oboucher/PestAlert/Website/SDP Website/Files/Images/Madelyn.jpg

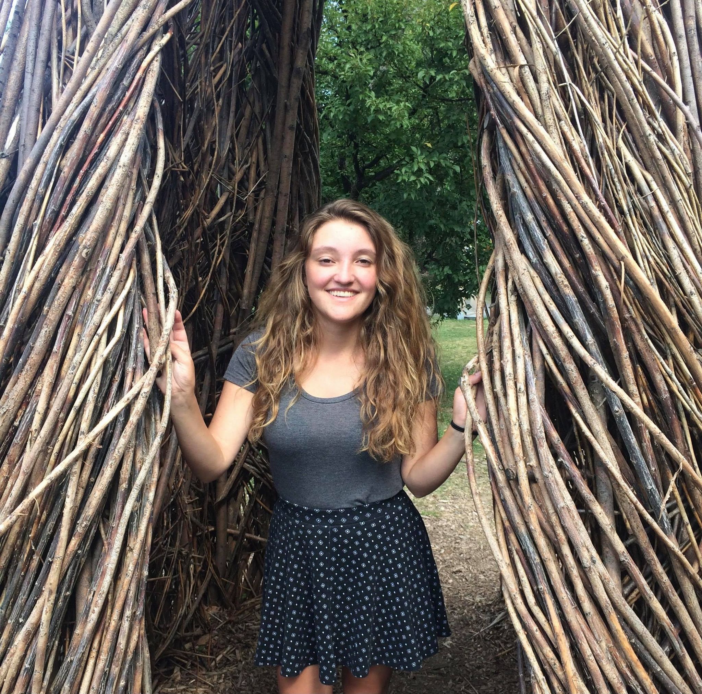
Website/SDP Website/Files/Images/Madelyn.jpg
