oboucher/PestAlert/Website/SDP Website/Files/Images/Owen.jpg

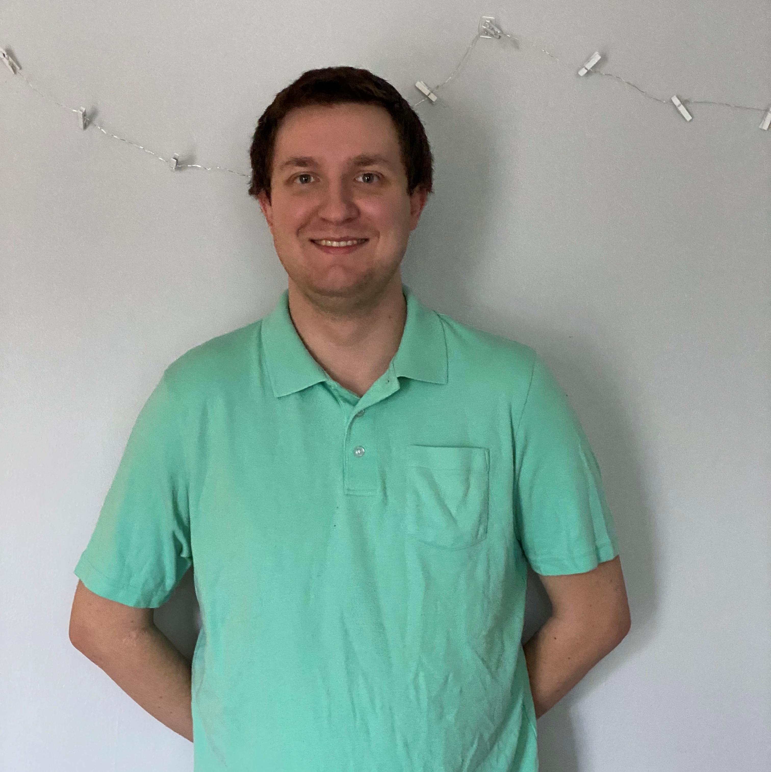
Website/SDP Website/Files/Images/Owen.jpg
