oboucher/PestAlert/Website/SDP Website/Files/Slides/PDR_Slides.pdf

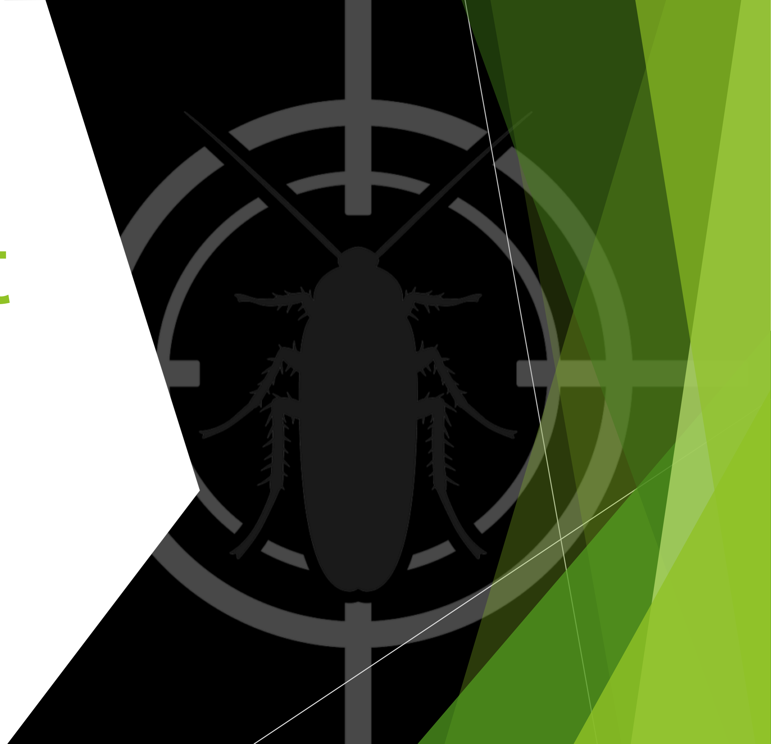
[picture p3: figure]

# Pest Alert

## Group 22 Aisha Ben-Neticha (EE) Owen Boucher (EE) Angela Wong (CompE) Madelyn Wright (EE)

# Problem Statement

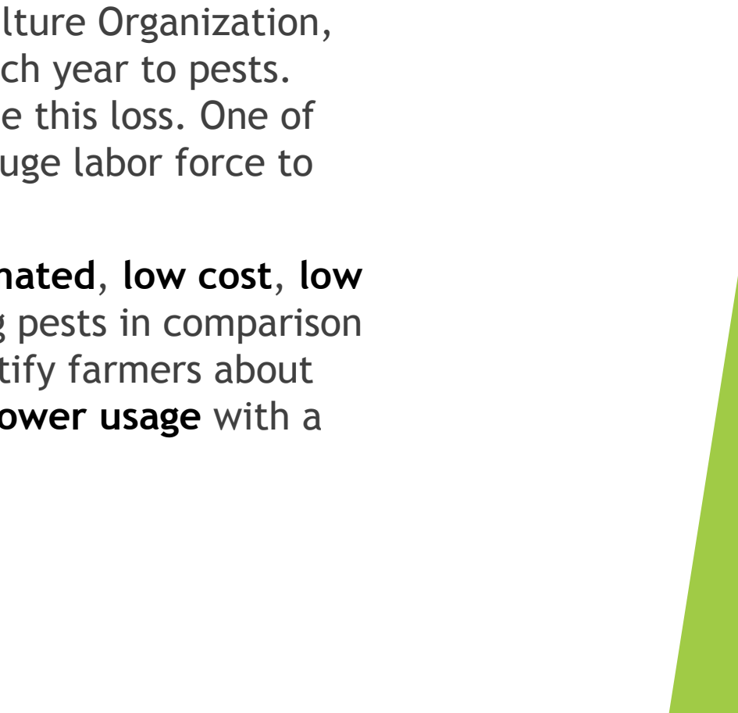
[picture p4: figure]

According to the United Nations Food and Agriculture Organization, between 20 and 40 percent of food crops are lost each year to pests.

### Integrated Pest Management, or IPM, can help reduce this loss. One of the major problems facing IPM is that it requires a huge labor force to

monitor pests.

### Our system, Pest Alert, seeks to create an automated, low cost, low power, and low maintenance system for monitoring pests in comparison to its competitors. Our system will automatically notify farmers about possible infestations, as well as managing its own power usage with a

solar panel and battery.

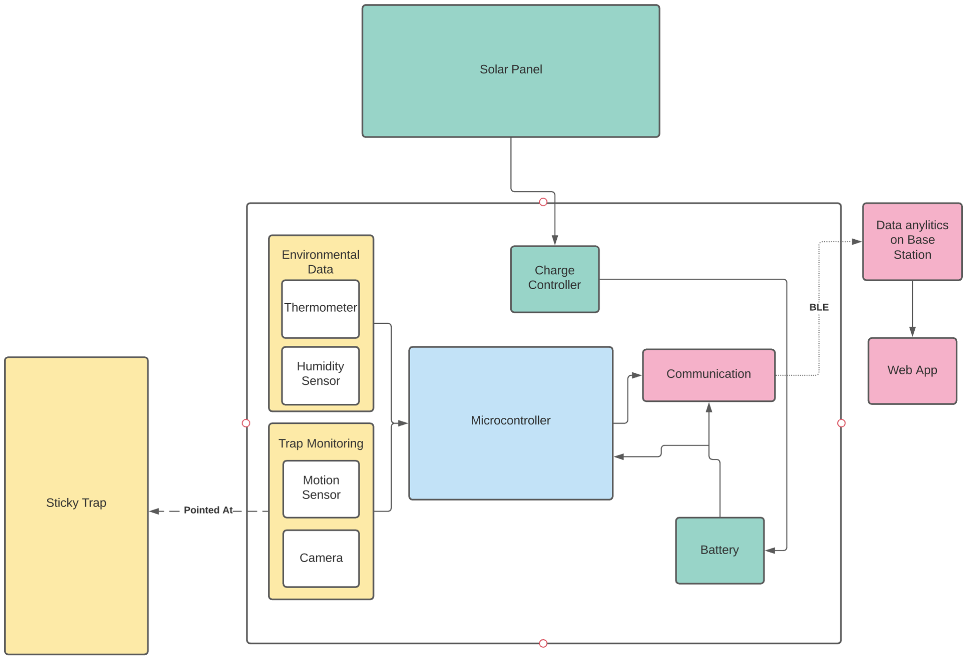
[picture p5: page 3]

# Competing Solutions -Microsoft/Azure Farm Beats

u Service that uses ML and
AI to help farmers
u Uses data-driven techniques to increase agricultural productivity by
enabling data collection from sensors, cameras, and drones.
u Weakness: Relies on a big battery or resort to minimal operation during night or extreme weather conditions such as snow and clouds. Farmbeats is also significantly more complex and requires users to have knowledge of Azure web services.

# Competing Solutions

# Rentokil Digital Pest Control

u Provide customers unrivaled pest data, insights and reporting to help proactively prevent, monitor and manage pests with efficiency
and control.
u Uses infrared beams and
sensor technology
u Insect light traps that use LED lighting rather than traditional fluorescent tubes, reducing energy uses by up to 70%
u This company focuses more on non
toxic solutions to pests rather than monitoring, whereas our solution is doing more by identifying pests and counting the total

# Competing Solutions

# Trap View

u This is an energy independent and weather resistant system with pheromone traps that send pictures of lured pests.
u All pictures from pest traps are gathered, processed and securely archived. The pests that are recognized are automatically marked.
u An application with powerful analytical tools allows you to efficiently monitor and successfully respond to the situation in the field.
u This product focuses on simplicity, while ours will also address cost and in turn power efficiency. It also uses pheromone traps which limits the pests.

# System Specifications

u System must be operable in the range of 0ºC to 50ºC
u Sensors
u Low powered camera to capture images of and identify number of pests on sticky trap (<5mW) u Motion detection determines beginning of system functionality in order to reduce power consumption
u Temperature/Humidity sensors to collect surrounding environmental data and observe correlation between environment and pest accumulation
u Power
u Battery life of 24 hours on full charge: Used to power sensors and should last at least 3 months (with charging) without any interference
u Solar Panel: Recharge half of the battery with one day of sunlight
u Reduce monitoring at night and operate in very low power mode by reducing overall operation because energy cannot be harvested in the dark
u Traps should be replaced every two months, when they are full, or when they lose their stickiness. u Low power communication between sensors and server using Bluetooth Low Energy (<100mW)

# Software Design

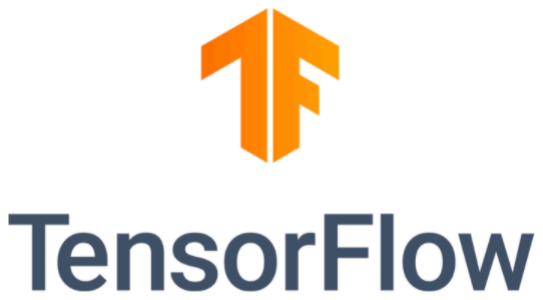
[picture p6: figure]

u Web Application Running on Base station u TensorFlow Lite using IP102 dataset
u MYSQL Database
u Possible User Interface -->
u Sending sensor data to Base station over BLE u Click on desired sensor name
u Real time sensor data shown
u Click and data will be sent to server
u Notifying user when pest count goes over threshold
u Showcasing images taken from camera

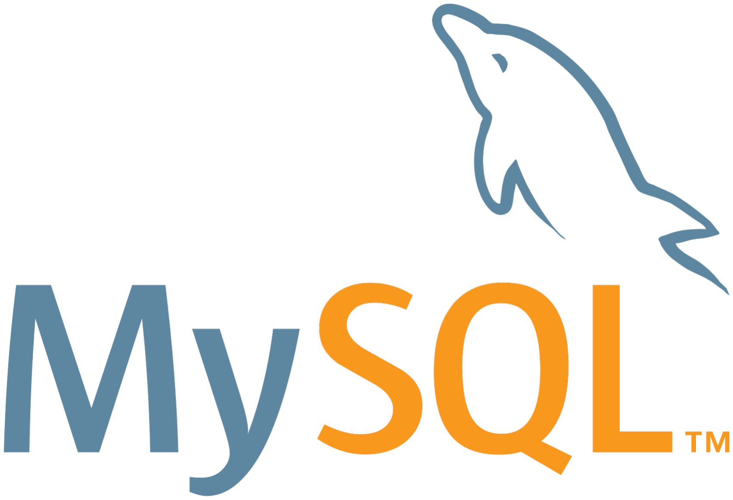
[picture p7: figure]

# Data Requirements

u Collecting/Storing/Testing Data u Temperature
u Humidity
u Number of pests
u Type of pests

u TensorFlow Lite
u IP102 dataset for training

u https://github.com/xpwu95/IP102

# Significant Custom Hardware Design

u Low power microcontroller
u Microchip SAM L10: ATSAML10D16A-YF u BLE
u SPBTLE-RF
u Sensors
u Temperature: TMP36
u Humidity: SHTC3
u Motion Detector: IRA-S210ST01
u Camera: Arducam 2MP Plus OV2640
u Solar Panel: Seeed 313070004, 1W Solar Panel u Rechargeable Battery: 18650 cell @ 2500mAh u Charge IC: TI BQ2057CSNTR

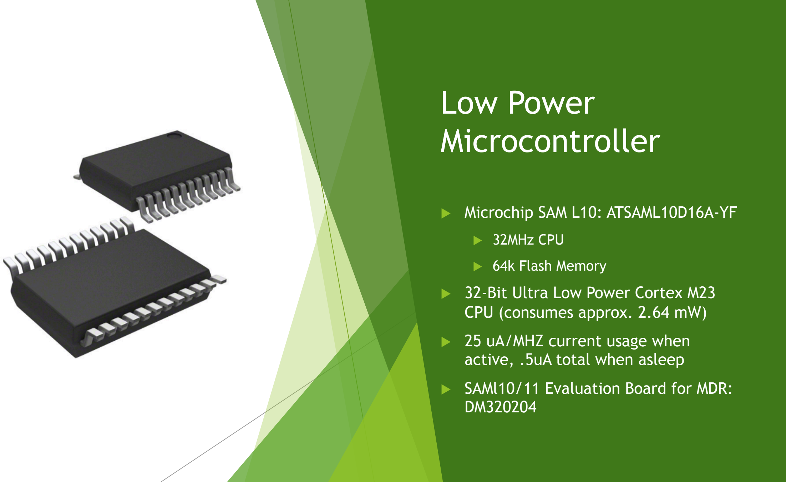
[picture p8: figure]
Low Power Microcontroller; u Microchip SAM L10: ATSAML10D16A-YF; u 32MHz CPU; u 64k Flash Memory u 32-Bit Ultra Low Power Cortex M23 CPU (consumes approx. 2.64 mW); u 25 uA/MHZ current usage when active, .5uA total when asleep; u SAMl10/11 Evaluation Board for MDR: DM320204

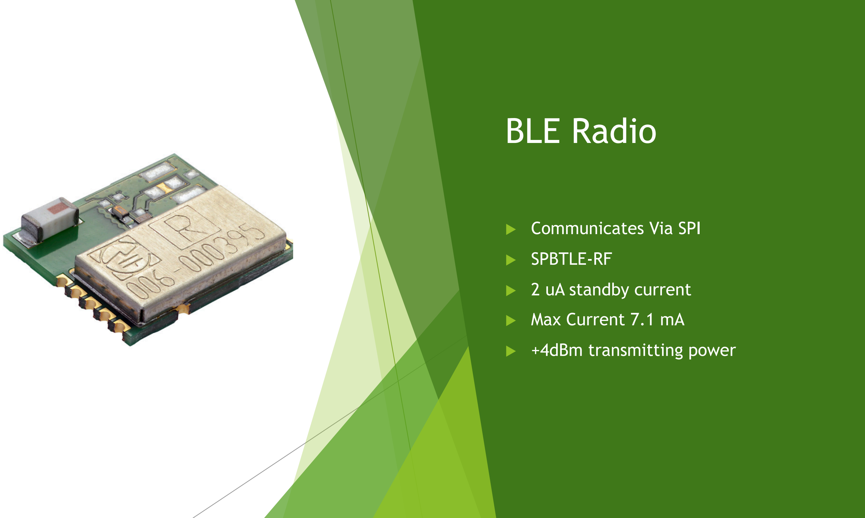
[picture p9: figure]
BLE Radio; u Communicates Via SPI; u SPBTLE-RF; u 2 uA standby current u Max Current 7.1 mA; u +4dBm transmitting power

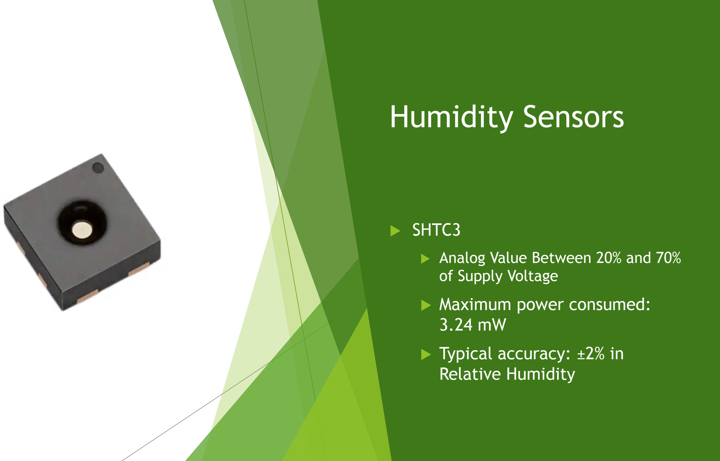
[picture p10: figure]
Humidity Sensors; u SHTC3; u Analog Value Between 20% and 70% of Supply Voltage u Maximum power consumed: 3.24 mW u Typical accuracy: ±2% in Relative Humidity

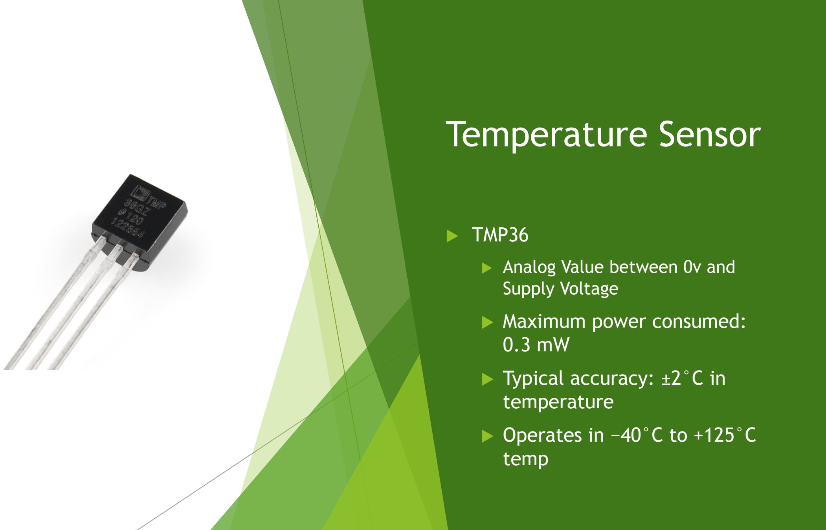
[picture p11: figure]
Temperature Sensor; u TMP36; u Analog Value between 0v and Supply Voltage u Maximum power consumed: 0.3 mW u Typical accuracy: ±2°C in temperature u Operates in −40°C to +125°C temp

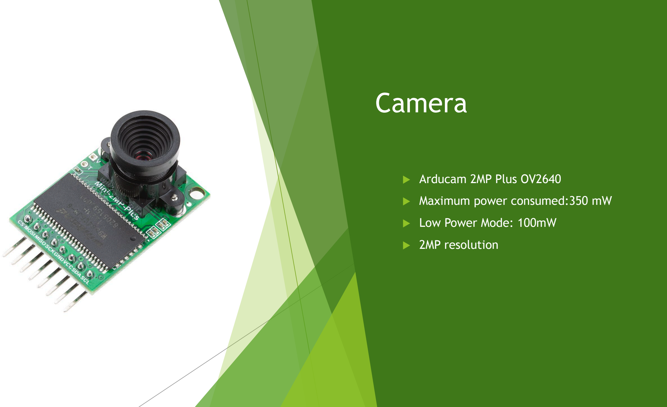
[picture p12: figure]
Camera; u Arducam 2MP Plus OV2640; u Maximum power consumed:350 mW; u Low Power Mode: 100mW; u 2MP resolution

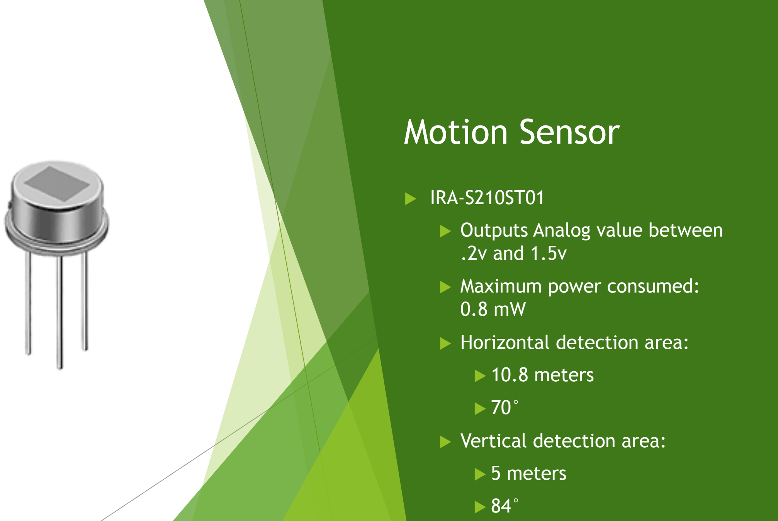
[picture p13: figure]
Motion Sensor; u IRA-S210ST01 u Outputs Analog value between .2v and 1.5v u Maximum power consumed: 0.8 mW u Horizontal detection area: u 10.8 meters u 70° u Vertical detection area: u 5 meters u 84°

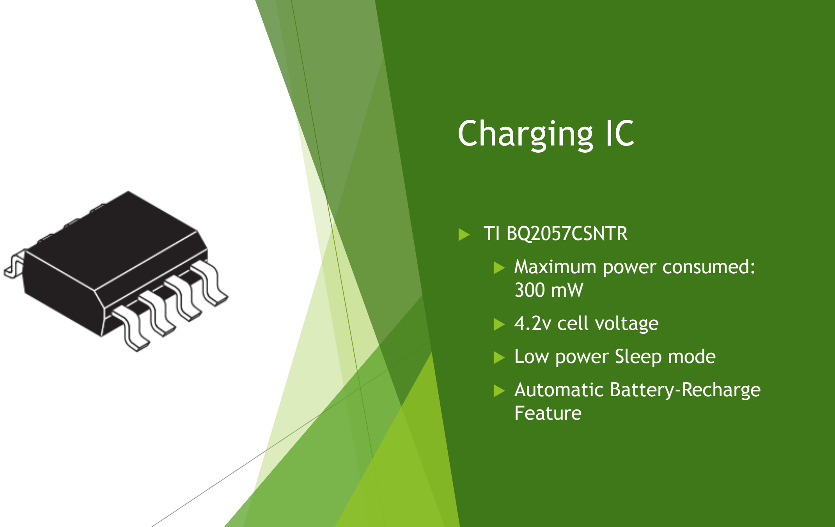
[picture p14: figure]
Charging IC; u TI BQ2057CSNTR u Maximum power consumed: 300 mW u 4.2v cell voltage u Low power Sleep mode u Automatic Battery-Recharge Feature

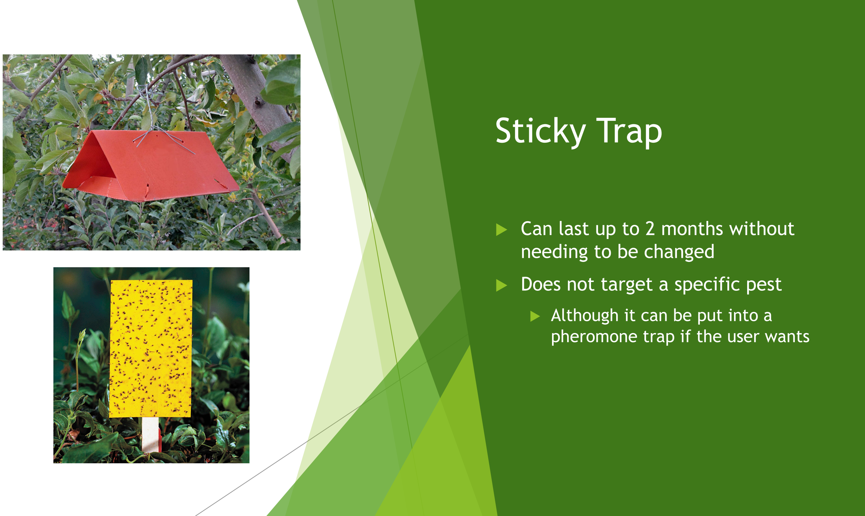
[picture p15: figure]
Sticky Trap; u Can last up to 2 months without needing to be changed u Does not target a specific pest; u Although it can be put into a pheromone trap if the user wants

# Solar Panel and Battery Sizing

Max Possible Power Use: approx. 400mW
Max Possible Energy Use Daily: 24hrs * 400mW = 9.6 Wh/day
The battery needs to be able to run without a solar power for one day, so we need a 9.6Wh battery.

This means for the battery we can use a single 18650 cell, rated at 3.7V and 2500mAh, because it can supply absolute maximum power for one day.

Assuming that the maximum power will not be reached due to the low power design of our system. We can use a 1W solar panel since it can supply enough power for the battery to almost fully recharge daily.

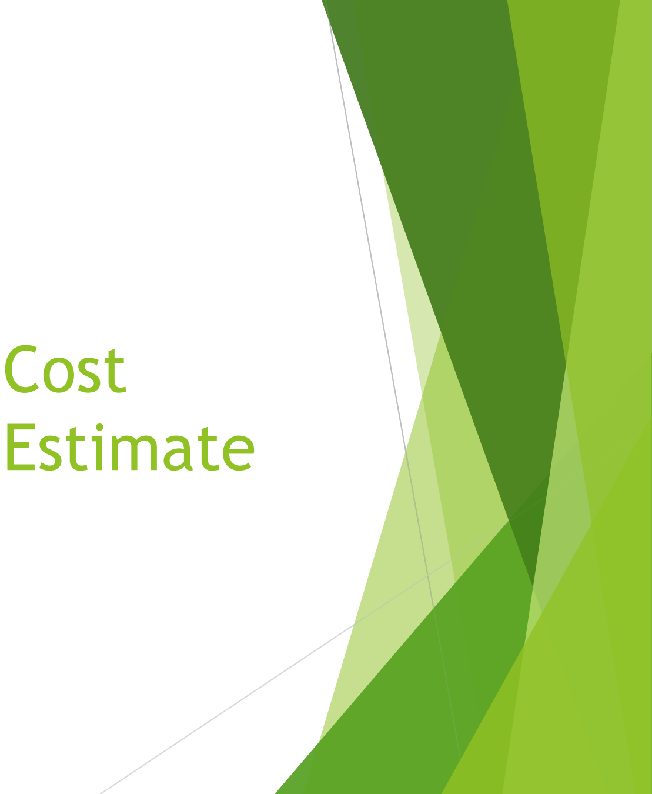
[picture p16: figure]
Cost Estimate

Component | Price($)
Microcontroller | 2.13
BLE Radio | 10.45
Humidity Sensor | 1.50
Temperature Sensor | 2.98
Camera | 9.95
Motion Sensor | 3.12
Charging IC | 2
Battery | 5
Solar Panel | 4
Sticky Traps | 9.99
Total Cost of Major Assembly Components | 51.12
SAM L10 Development Board | 60
Total Cost | 111.12

# Team Roles

u Communication, PCB, and Data Visualization: Owen Boucher u Pest Monitoring/Environmental Sensors : Aisha Ben-Neticha u Data Processing and Conditioning: Angela Wong
u Energy Management: Madelyn Wright

# Team Responsibilities

u Team Coordinator: Madelyn Wright
u Cost Lead: Angela Wong
u Altium Lead: Owen Boucher

# Proposed MDR Deliverables

Owen:
u BLE Communication established
u Framework of visual representation
Aisha:
u Temperature, humidity, and motion detecting sensors configured and functioning (w/ 70% accuracy) u Camera is configured; can capture images when motion sensor is triggered
Angela:
u Database configured, data conditioning is successful
u 70% accuracy in bug detection
Madelyn:
u Connection between solar panel and battery made u Code configured to operate in low power modes u Panel can successfully supply power to sensors

# Gantt Chart

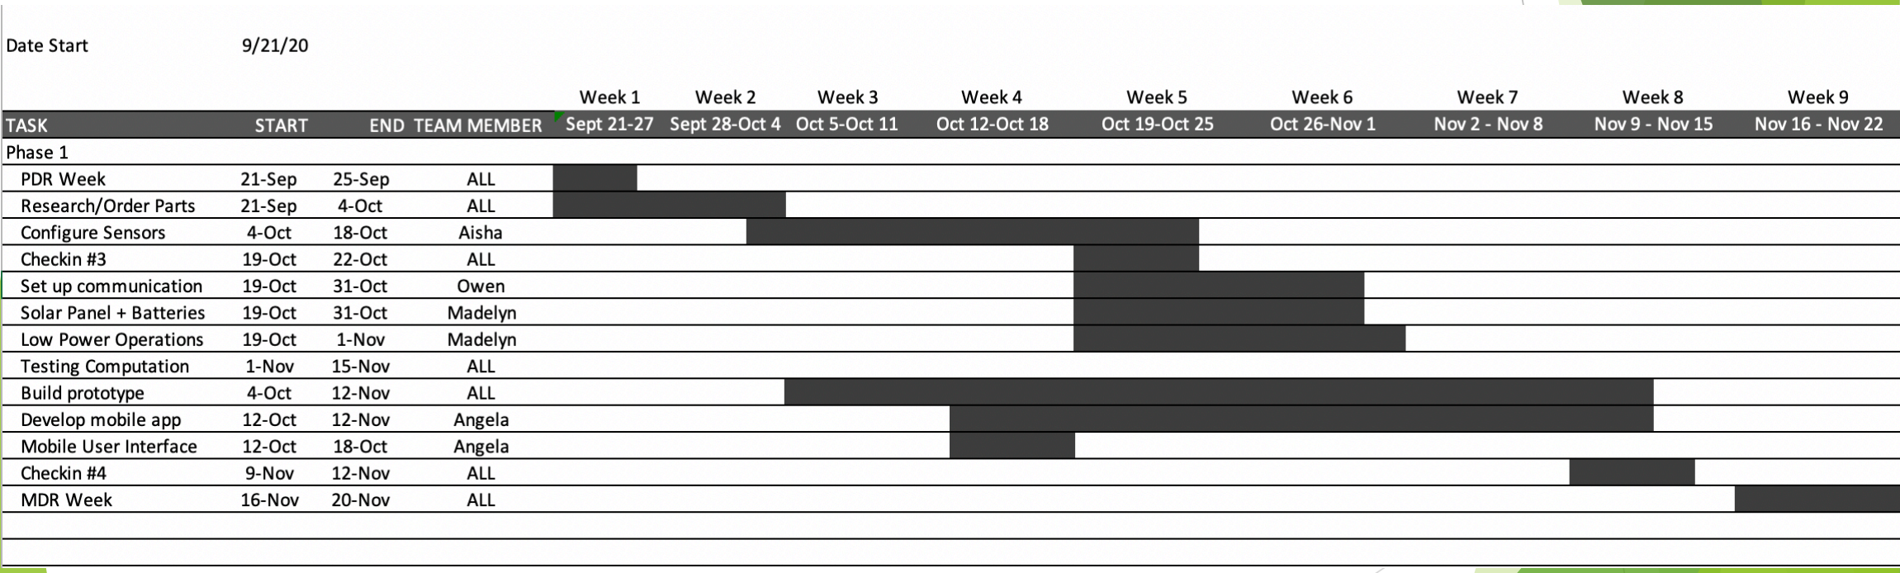
[picture p17: figure]

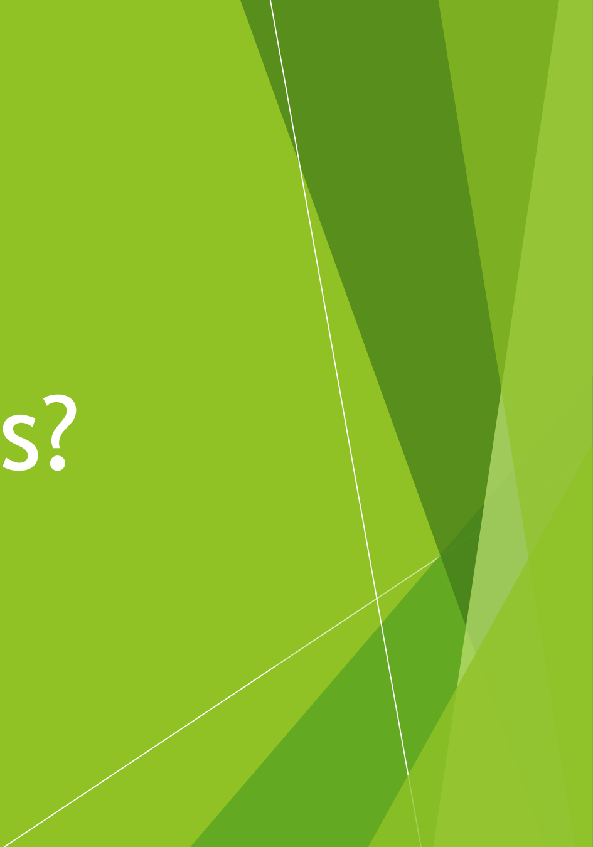
[picture p18: figure]

# Questions?
