oboucher/PestAlert/Website/SDP Website/Files/Images/Aisha.jpg

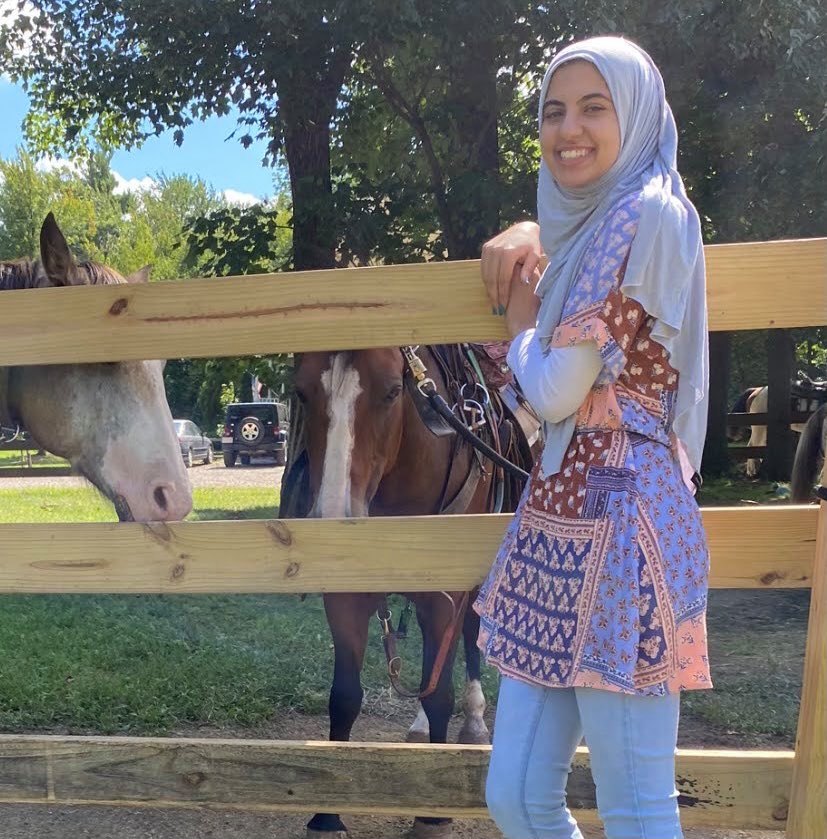
Website/SDP Website/Files/Images/Aisha.jpg
