oboucher/PestAlert/Website/SDP Website/Files/Images/Angela.jpg

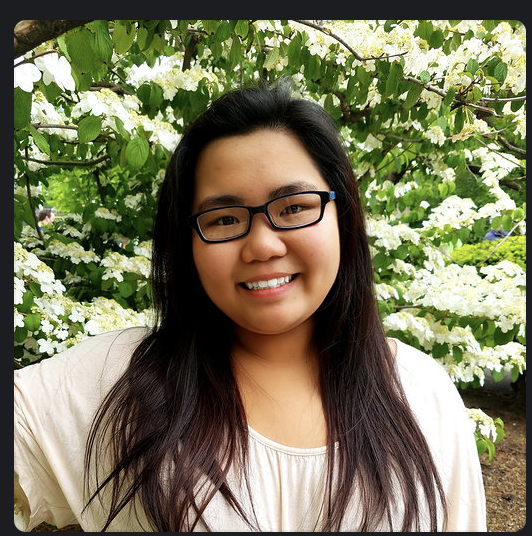
Website/SDP Website/Files/Images/Angela.jpg
