oboucher/PestAlert/Website/SDP Website/Files/Images/Hardware.jpg

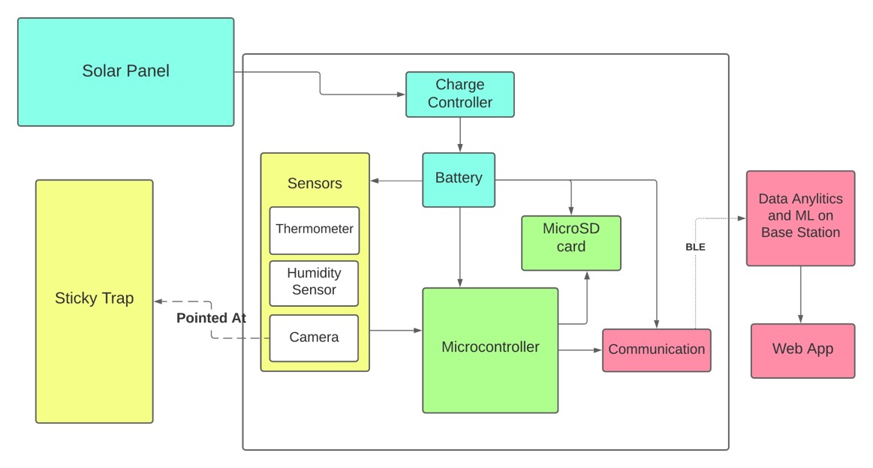
Website/SDP Website/Files/Images/Hardware.jpg
