oboucher/PestAlert/Website/SDP Website/Files/Images/Software.jpg

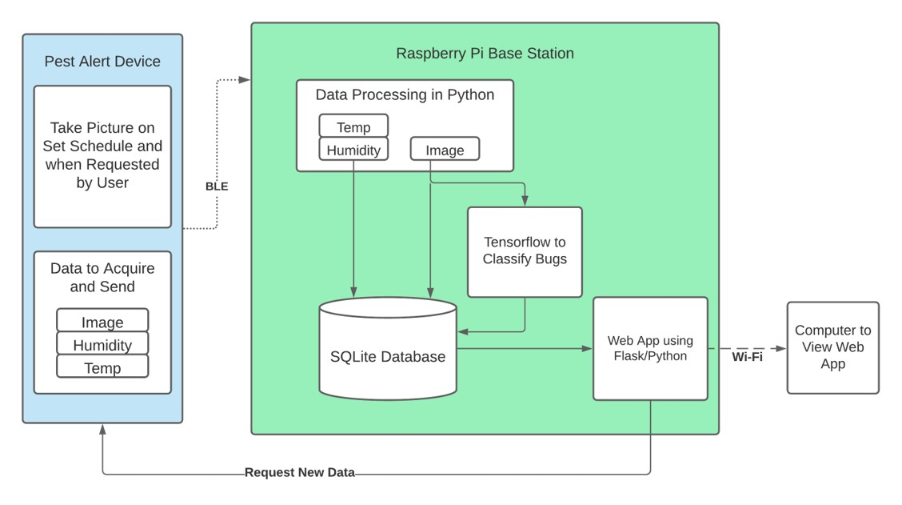
Website/SDP Website/Files/Images/Software.jpg
