oboucher/PestAlert/Altium/Project Outputs for PestAlert/BOM.xlsx

Comment | Description | Designator | Footprint | LibRef | Quantity
Cap Semi | Capacitor (Semiconductor SIM Model) | C1, C2, C3, C4, C5, C6, C7, C8, C9 | C1206 | Cap Semi | 9
B340A-13-F | DIODE SCHOTTKY 40V 3A SMA | D1, D2 | FP-SMA-MFG | CMP-1667-00003-2 | 2
LG L29K-G2J1-24-Z | LED GREEN DIFFUSED 0603 SMD | D3, D4 | FP-LG_L29K-MFG | CMP-62016-000024-1 | 2
LB Q39E-N1OO-35-1 | LED BLUE DIFFUSED 0603 SMD | D5 | FP-LB_Q39E-MFG | CMP-62016-000029-1 | 1
BAT | Male Header, Pitch 2 mm, 1 x 2 Position, Height 6 mm, Tail Length 3.4 mm, -25 to 85 degC, RoHS, Bulk | J1 | JST-B2B-PH-K-S_V | CMP-2000-05162-1 | 1
SWD | Male Header, Pitch 2 mm, 1 x 2 Position, Height 6 mm, Tail Length 3.4 mm, -25 to 85 degC, RoHS, Bulk | J2 | JST-B2B-PH-K-S_V | CMP-2000-05162-1 | 1
SOL | Male Header, Pitch 2 mm, 1 x 2 Position, Height 6 mm, Tail Length 3.4 mm, -25 to 85 degC, RoHS, Bulk | J3 | JST-B2B-PH-K-S_V | CMP-2000-05162-1 | 1
THR | Male Header, Pitch 2 mm, 1 x 2 Position, Height 6 mm, Tail Length 3.4 mm, -25 to 85 degC, RoHS, Bulk | J4 | JST-B2B-PH-K-S_V | CMP-2000-05162-1 | 1
A-USBSB | Connector Receptacle, USB Type B, Right Angle, -20 to 85 degC, 4-Pin THD, RoHS, Tray | J5 | ASSM-A-USBSB-4_V | CMP-2000-05874-1 | 1
CAM | Male Header, Pitch 2 mm, 1 x 4 Position, Height 6 mm, Tail Length 3.4 mm, -25 to 85 degC, RoHS, Bulk | P1 | JST-B4B-PH-K-S_V | CMP-2000-05165-1 | 1
100k | RES SMD 100K OHM 1% 1/4W 1206 | R1, R2 | SMD-1206-RES | ERJ-8ENF1003V | 2
10k | RES SMD 10K OHM 1% 1/4W 1206 | R3, R4, R6 | SMD-1206-RES | ERJ-8ENF1002V | 3
1k | RES SMD 1K OHM 1% 1/4W 1206 | R5, R9, R10, R11 | SMD-1206-RES | ERJ-8ENF1001V | 4
22 | RES SMD 22 OHM 1% 1/4W 1206 | R7, R8 | SMD-1206-RES | ERJ-8ENF22R0V | 2
503500-0991 | SD and Combo Memory Card Connector, 9 Position Surface Mount, -25 to 85 degC, RoHS, Tape and Reel | SD1 | MOLX-503500-0991_V | CMP-1676-00006-1 | 1
RST | SWITCH TACTILE SPST-NO 0.05A 24V | SW1 | FP-1825910-2-0 | CMP-03407-000004-1 | 1
MDBT50Q-1MV2 | MDBT50Q-1MV2 | U1 | XCVR_MDBT50Q-1MV2 | MDBT50Q-1MV2 | 1
BQ24074RGTT | USB-Friendly Li-Ion Battery Charger and Power-Path Management IC, 10.5 V OVP, 4.3 V, -40 to 85 degC, 16-pin QFN (RGT), Green (RoHS & no Sb/Br) | U2 | RGT0016C_V | CMP-0321-00218-2 | 1
TC1262-3.3VAB | 500mA Fixed Output CMOS LDO, 3-Pin TO-220, Extended Temperature | U3 | TO-220-AB3 | CMP-0136-01006-1 | 1
HPP845E031R4 | Digital Relative Humidity Sensor with Temperature Output, 1.5 to 3.6 V, -40 to 125 degC, 6-Pin SON, RoHS, Tape and Reel | U4 | TECO-SON-6_V | CMP-2100-03646-1 | 1
ABS25-32.768KHZ-T | Low Frequency Crystal, 32.768 KHz, -40 to 85 degC, 4-Pin SMD, RoHS, Tape and Reel | X1 | ABRA-ABS25-4_V | CMP-2000-05037-1 | 1
Part | Description / Value | Footprint | Cost | Bulk Cost | LINK
C1 | 10uF | 1206 | $0.18 | $0.03 | https://www.digikey.com/en/products/detail/samsung-electro-mechanics/CL31B106KQHNFNE/3888765
C2 | 22pF | 1206 | $0.11 | $0.08 | https://www.digikey.com/en/products/detail/würth-elektronik/885012008002/5453717
C3 | 10nF | 1206 | $0.23 | $0.05 | https://www.digikey.com/en/products/detail/kemet/C1206C103KAREC7800/8644247
C4 | 22pF | 1206 | $0.11 | $0.08 | https://www.digikey.com/en/products/detail/würth-elektronik/885012008002/5453717
C5 | 100uF | 1206 | $1.12 | $0.44 | https://www.digikey.com/en/products/detail/tdk-corporation/C3216X5R0G107M160AB/2443487
C6 | 22pF | 1206 | $0.11 | $0.08 | https://www.digikey.com/en/products/detail/würth-elektronik/885012008002/5453717
C7 | 22pF | 1206 | $0.11 | $0.08 | https://www.digikey.com/en/products/detail/würth-elektronik/885012008002/5453717
C8 | 10uF | 1206 | $0.18 | $0.03 | https://www.digikey.com/en/products/detail/samsung-electro-mechanics/CL31B106KQHNFNE/3888765
C9 | 100nF | 1206 | $0.49 | $0.13 | https://www.digikey.com/en/products/detail/vishay-vitramon/VJ1206Y104MXBAT/8318810
R1 | 100K | 1206 | $0.10 | $0.01 | https://www.digikey.com/en/products/detail/yageo/RE1206FRE07100KL/5924252
R2 | 100K | 1206 | $0.10 | $0.01 | https://www.digikey.com/en/products/detail/yageo/RE1206FRE07100KL/5924252
R3 | 10K | 1206 | $0.10 | $0.01 | https://www.digikey.com/en/products/detail/yageo/RE1206FRE0710KL/5924263
R4 | 10K | 1206 | $0.10 | $0.01 | https://www.digikey.com/en/products/detail/yageo/RE1206FRE0710KL/5924263
R5 | 1K | 1206 | $0.10 | $0.01 | https://www.digikey.com/en/products/detail/stackpole-electronics-inc/RNCP1206FTD1K00/2240337
R6 | 10K | 1206 | $0.10 | $0.01 | https://www.digikey.com/en/products/detail/yageo/RE1206FRE0710KL/5924263
R7 | 22R | 1206 | $0.10 | $0.00494 | https://www.digikey.com/en/products/detail/stackpole-electronics-inc/RMCF1206FT22R0/1759698
R8 | 22R | 1206 | $0.10 | $0.00494 | https://www.digikey.com/en/products/detail/stackpole-electronics-inc/RMCF1206FT22R0/1759698
R9 | 1K | 1206 | $0.10 | $0.01 | https://www.digikey.com/en/products/detail/stackpole-electronics-inc/RNCP1206FTD1K00/2240337
R10 | 1K | 1206 | $0.10 | $0.01 | https://www.digikey.com/en/products/detail/stackpole-electronics-inc/RNCP1206FTD1K00/2240337
R11 | 1K | 1206 | $0.10 | $0.01 | https://www.digikey.com/en/products/detail/stackpole-electronics-inc/RNCP1206FTD1K00/2240337
D1 | B340A - Zenier Diode - 40V 3A SMA | FP-SMA-MFG | $0.43 | $0.12 | https://www.digikey.com/en/products/detail/diodes-incorporated/B340A-13-F/725015
D2 | B340A - Zenier Diode - 40V 3A SMA | FP-SMA-MFG | $0.43 | $0.12 | https://www.digikey.com/en/products/detail/diodes-incorporated/B340A-13-F/725015
U2 | BQ24074RGTT | QFN16 | $2.52 | $1.71 | https://www.digikey.com/en/products/detail/texas-instruments/BQ24074RGTT/1957746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
U3 | TC1262-3.3VAB - 3.3V 500mA regulator | Thru Hole | $0.86 | $0.65 | https://www.digikey.com/en/products/detail/microchip-technology/TC1262-3-3VAB/442716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
SD1 | 503500-0991 - SD Card Slot | MOLX-503500-0991_V | $4.72 | $3.30 | https://www.digikey.com/en/products/detail/molex/5035000991/3045270?s=N4IgTCBcDaIKwAYDMiEFoEE5MEYQF0BfIA
J5 | A-USBSB - USB B Thru Hole Jack | ASSM-A-USBSB-4_V | $0.62 | $0.62 | https://www.digikey.com/en/products/detail/assmann-wsw-components/A-USBSB/331973
D3 | LG L29K-G2J1-24-Z - Green LED | FP-LG_L29K-MFG | $0.50 | $0.11 | https://www.digikey.com/en/products/detail/osram-opto-semiconductors-inc/LG-L29K-G2J1-24-Z/1938740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
D4 | LG L29K-G2J1-24-Z - Green LED | FP-LG_L29K-MFG | $0.50 | $0.11 | https://www.digikey.com/en/products/detail/osram-opto-semiconductors-inc/LG-L29K-G2J1-24-Z/1938740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
D5 | LB Q39E-N1OO-35-1 - Blue LED | FP-LB_Q39E-MFG | $0.43 | $0.10 | https://www.digikey.com/en/products/detail/osram-opto-semiconductors-inc/LB-Q39E-N1OO-35-1/2176321
X1 | ABS25-32.768KHZ-T - 32.768kHz oscillator | ABRA-ABS25-4_V | $0.55 | $0.29 | https://www.mouser.com/ProductDetail/ABRACON/ABS25-32768KHZ-T/
U1 | MDBT50Q-1MV2 - nRF52840 BLE Module | XCVR_MDBT50Q-1MV2 | $10.14 | $10.14 | https://www.digikey.com/en/products/detail/seeed-technology-co-ltd/113990584/9697027
U4 | HPP845E031R4 - Temperature and Humidity Sensor I2C | TECO-SON-6_V | $4.61 | $3.22 | https://www.digikey.com/en/products/detail/te-connectivity-measurement-specialties/HPP845E031R4/3945784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
RST | SWITCH TACTILE SPST-NO 0.05A 24V - Tacticle Switch | Thru Hole | $0.10 | $0.05 | https://www.digikey.com/en/products/detail/te-connectivity-alcoswitch-switches/1825910-6/1632536
BAT | JST-PH Connector | JST-B4B-PH-K-S_V | $0.15 | $0.06 | https://www.digikey.com/en/products/detail/jst-sales-america-inc/B2B-XH-A(LF)(SN)/1651045
THR | JST-PH Connector | JST-B4B-PH-K-S_V | $0.15 | $0.06 | https://www.digikey.com/en/products/detail/jst-sales-america-inc/B2B-XH-A(LF)(SN)/1651045
CAM | JST-PH Connector | JST-B4B-PH-K-S_V | $0.15 | $0.06 | https://www.digikey.com/en/products/detail/jst-sales-america-inc/B2B-XH-A(LF)(SN)/1651045
SOL | JST-PH Connector | JST-B4B-PH-K-S_V | $0.15 | $0.06 | https://www.digikey.com/en/products/detail/jst-sales-america-inc/B2B-XH-A(LF)(SN)/1651045
SWD | JST-PH Connector | JST-B4B-PH-K-S_V | $0.15 | $0.06 | https://www.digikey.com/en/products/detail/jst-sales-america-inc/B2B-XH-A(LF)(SN)/1651045
Camera
Battery
SD Card
Antenna
 |  | BOM COST | 30.9 | 21.95023
