oboucher/PestAlert/Altium/Project Outputs for PestAlert/Rev1PCBDocuments.pdf

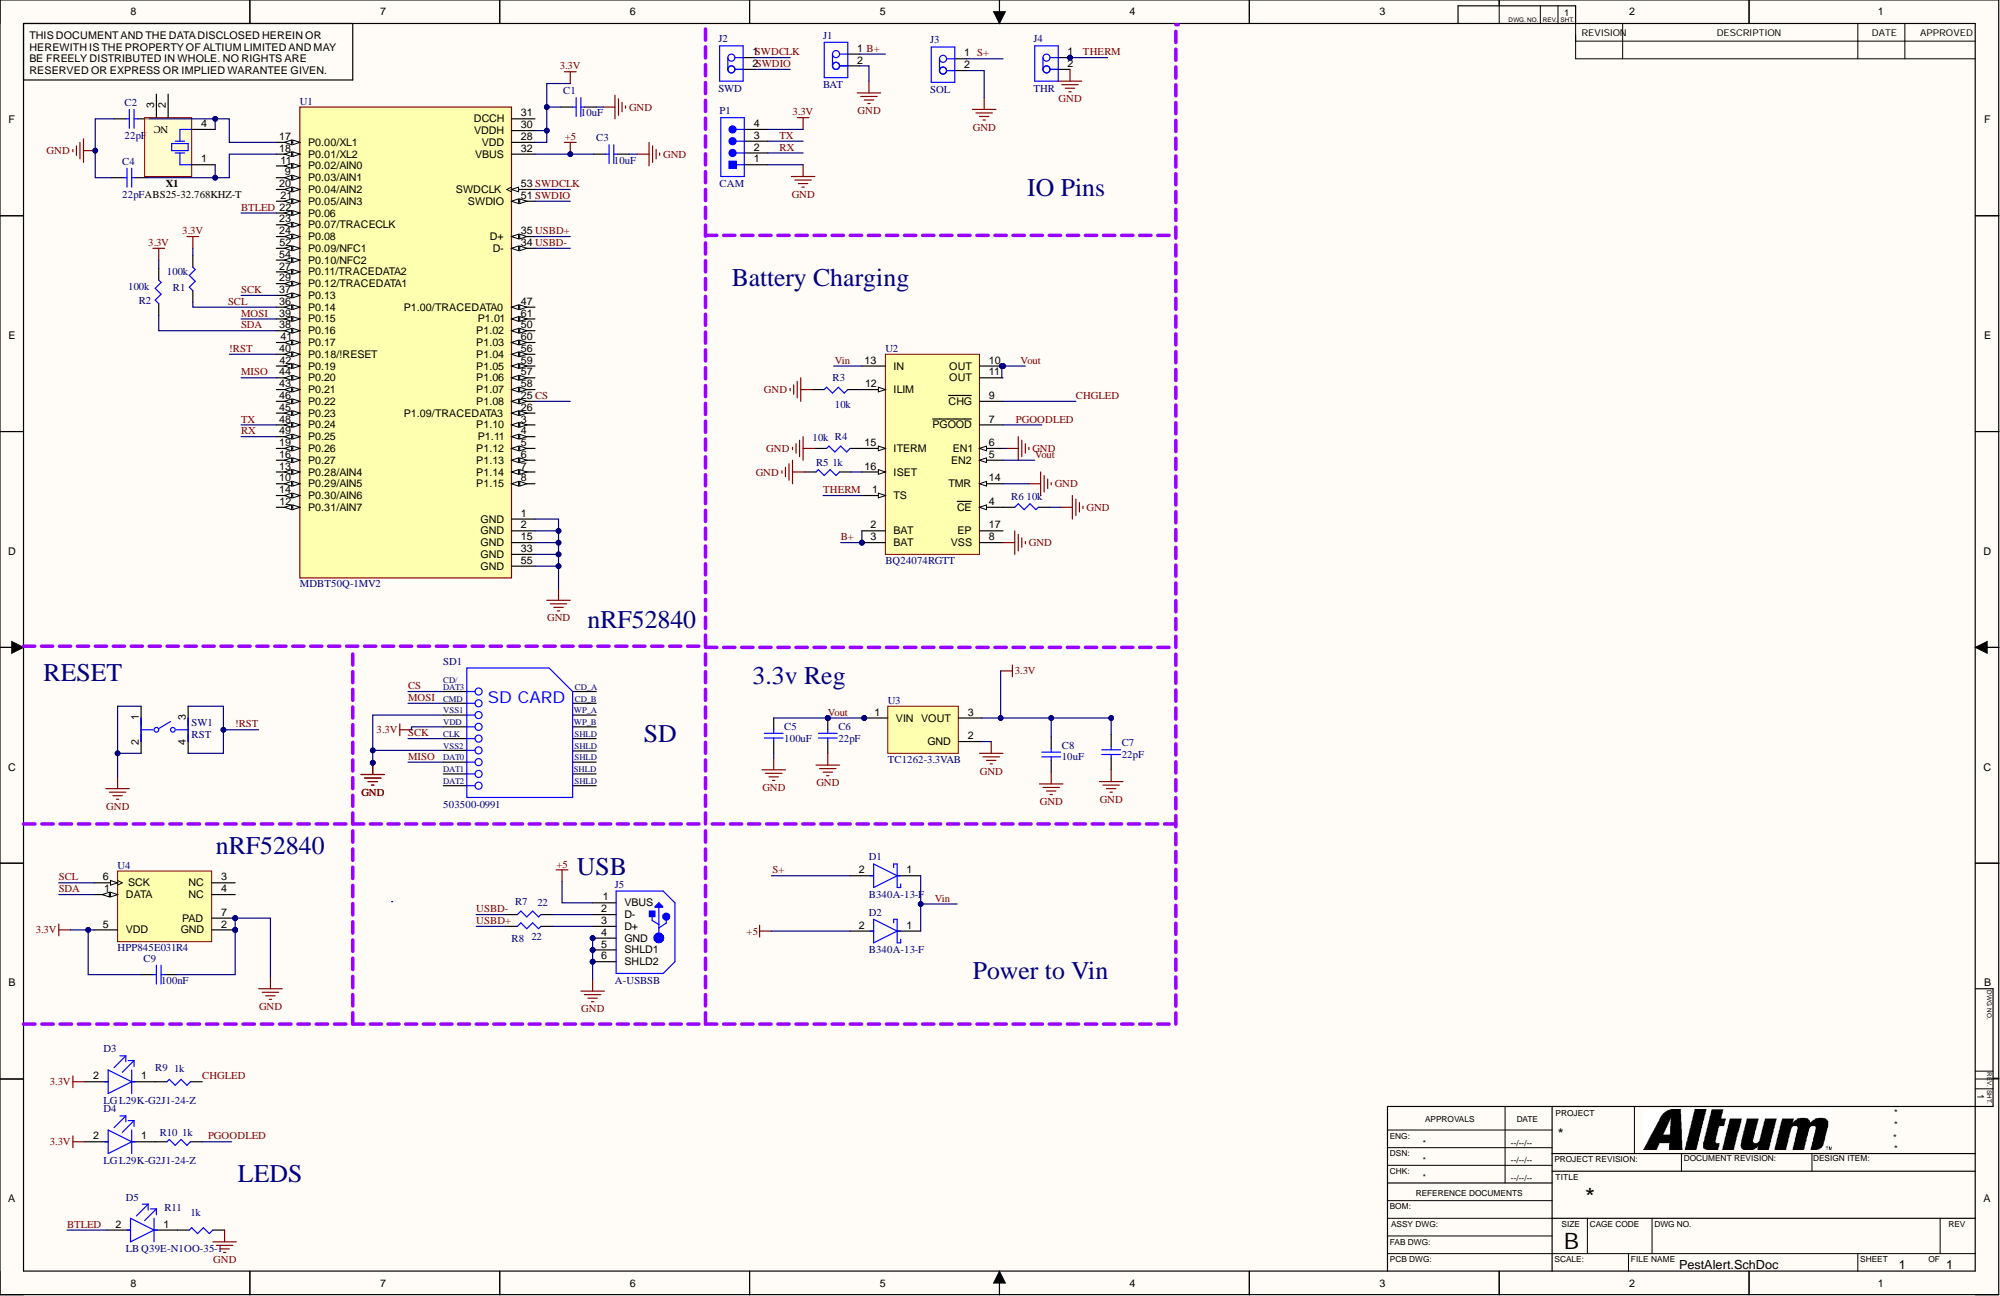
[picture p25: page 1]

DWG. NO. | REV. | 1 SHT.

THIS DOCUMENT AND THE DATA DISCLOSED HEREIN OR HEREWITH IS THE PROPERTY OF ALTIUM LIMITED AND MAY BE FREELY DISTRIBUTED IN WHOLE. NO RIGHTS ARE RESERVED OR EXPRESS OR IMPLIED WARANTEE GIVEN. | | | | REVISION | DESCRIPTION | DATE | APPROVED

REV. SHT. DWG. NO.

DATE | PROJECT * | * * APPROVALS * *

ENG: * | --/--/--

DSN: * | --/--/--

CHK: * | --/--/--

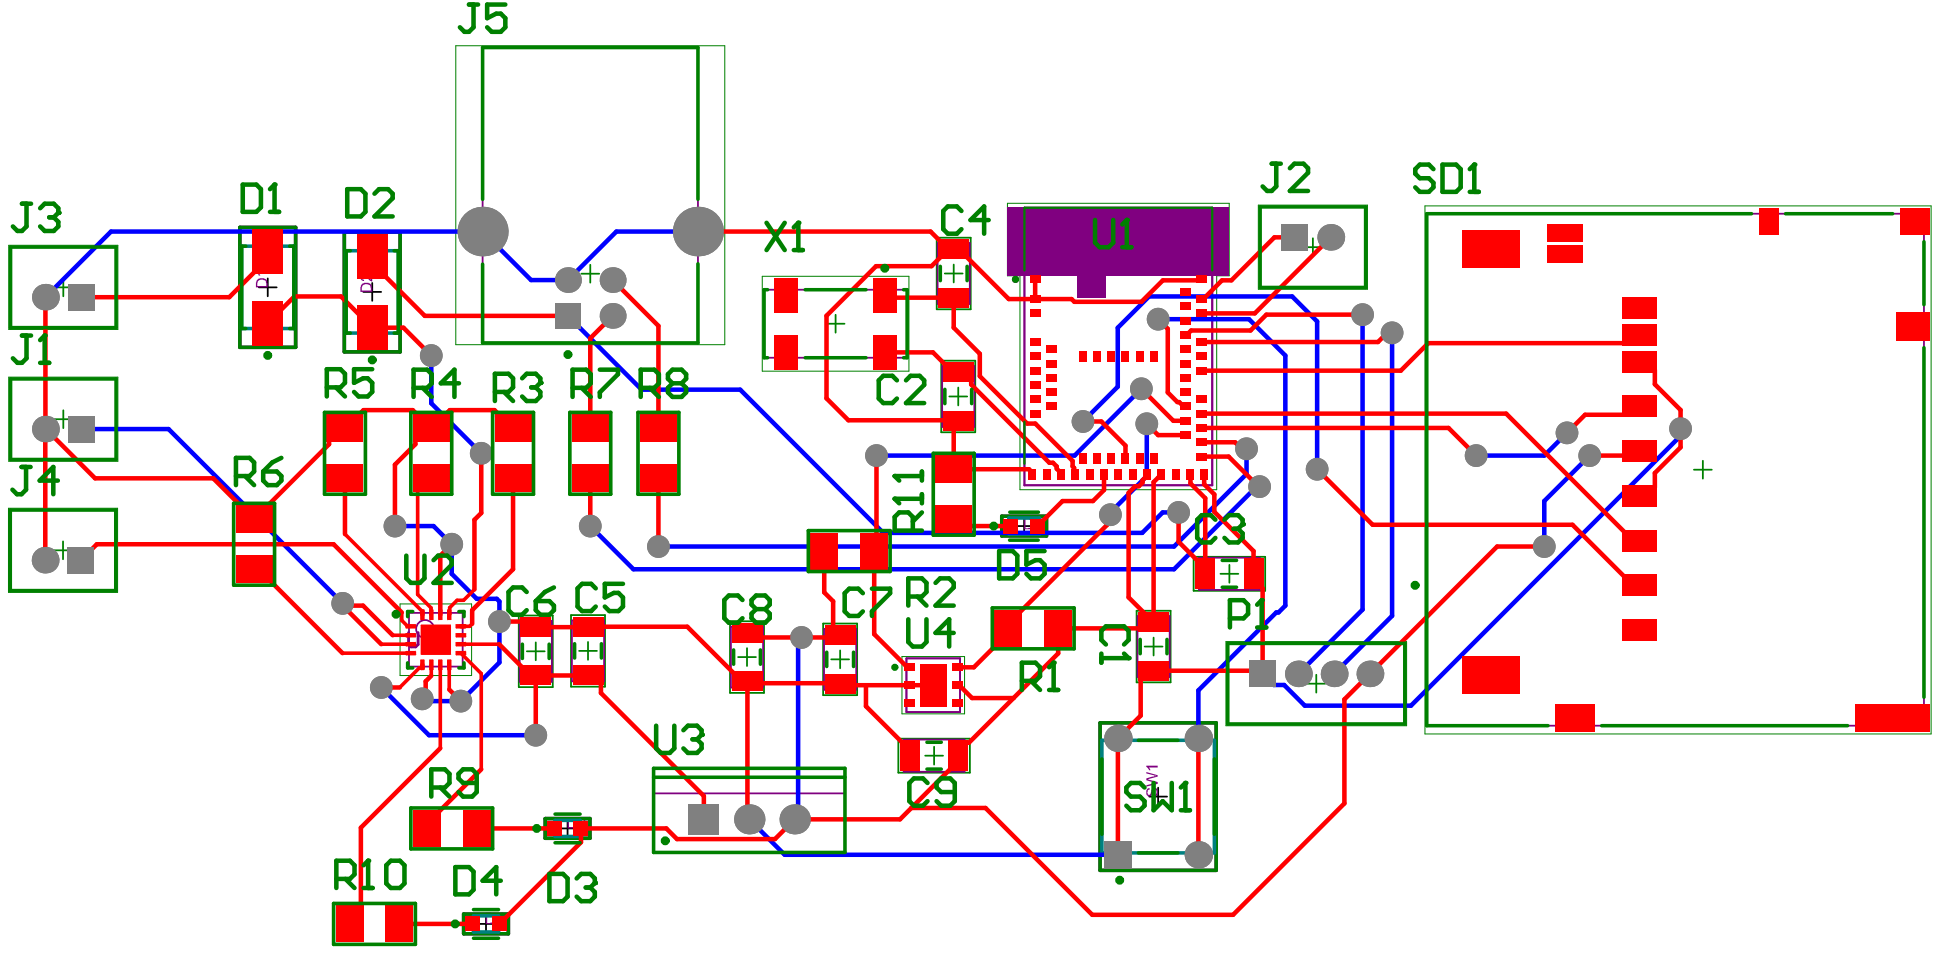
[picture p26: page 2]
