oboucher/PestAlert/(list of files, drawings)

Other design files:
Altium/History/00000000EC452A0E/PestAlert.~(1).SchDoc
Altium/PestAlert.PrjPcb
