oboucher/PestAlert/(commit log)

2021-02-04 Initial Commit of All Files
    [PestAlert.PrjPcb]
2021-02-04 Coments of Arduino code
2021-02-05 Altium File Commit
    [PestAlert.~(1).SchDoc]
2021-02-05 Altium Files for Ordering
    [PestAlert.GBL, PestAlert.GBO, PestAlert.GBS, PestAlert.GKO, PestAlert.GM1, PestAlert.GTL, PestAlert.GTO, PestAlert.GTS]
2021-02-05 Final PCB Before ordering
    [PestAlert.GBL, PestAlert.GBO, PestAlert.GBS, PestAlert.GKO, PestAlert.GM1, PestAlert.GTL, PestAlert.GTO, PestAlert.GTS]
2021-02-07 Fixed image name not sending issue
    [BLE_Inteface.py, PestAlert.ino]
2021-02-07 Began BOM and Trying to figure out import issue
    [BOM.xlsx, PestAlert.PrjPcb, PestAlert.csv]
2021-02-08 Finished BOM and made changes on BLE_interfacepy
    [BOM.xlsx]
2021-02-17 CODE MOSTLY WORKING NOW!!!!!!!!!!!!!!!!!!
    [BOM.xlsx]
2021-02-21 Small PCB Changes
2021-03-14 Create PCB
